TheHumbLegend/Jamal-Mechatronics-Robot/(commit log)

2026-06-07 Revise README for JAM-L project details
    Updated project name and expanded README with detailed features, hardware specifications, control system, robotic arm design, mechanical design, results, and authors.
2026-06-07 Refactor comments and clean up code in jamal.ino
    [jamal.ino]
